raphaelcoeffic/sport_ecu/(commit log)

2016-05-05 testing data & utility (to be used with logic analyser)
    [bug1.csv, bug2.csv]
2016-05-16 Moved from I2C terminal simulator to the Wireless Telemetry interface
    The I2C terminal interface did not work fast enough as the key presses were not accepted fast enough by the ECU. The wireless telemetry interface is based on serial communication and transmits all relevant data directly.
    The main platform has been moved to the Teensy-LC to take advantage of the multiple hardware serial interfaces and the half duplex inverted capabilities in hardware.
    [bug1.csv, bug2.csv]
2016-05-17 telem_decoder: fixed byte stuffing / check sum
    [telem_decoder.py]
2016-05-17 SportECU: fixed byte stuffing / check sum
    [SportECU.ino]
2016-05-17 reworked to support Arduinos (Pro mini) + status LED
    [SportECU.ino]
2016-05-19 added ECU connector pinout
2016-05-19 README: added ECU connector pinout
2016-05-19 added some more docs to help connecting teensy & arduino to the ECU
